Lucky-Enter/HPM5E31/hardware/HPM5E31.pdf

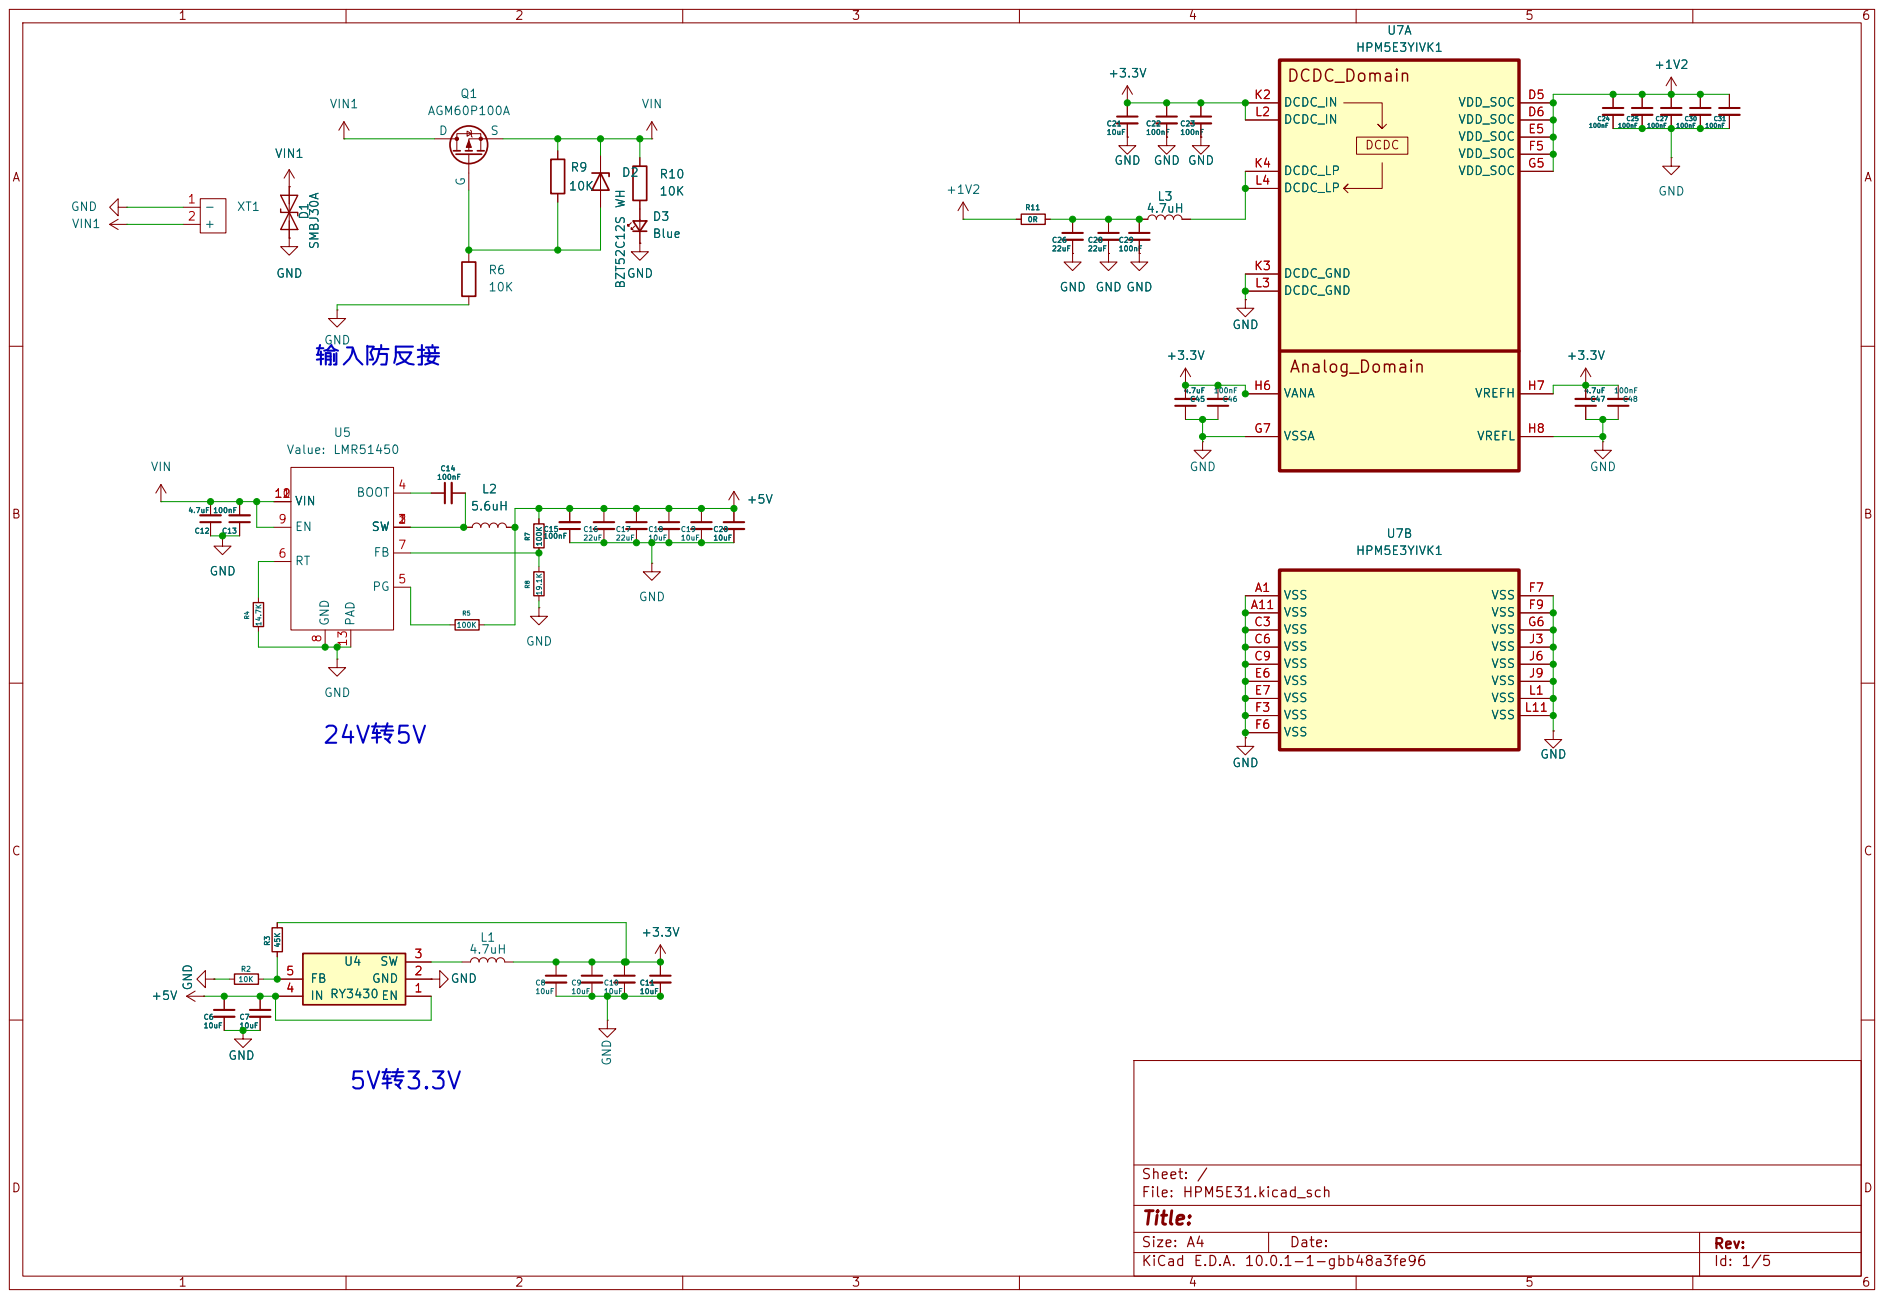
[picture p1: page 1]

Size: A4 | Rev:
KiCad E.D.A. 10.0.1-1-gbb48a3fe96 | Id: 1/5

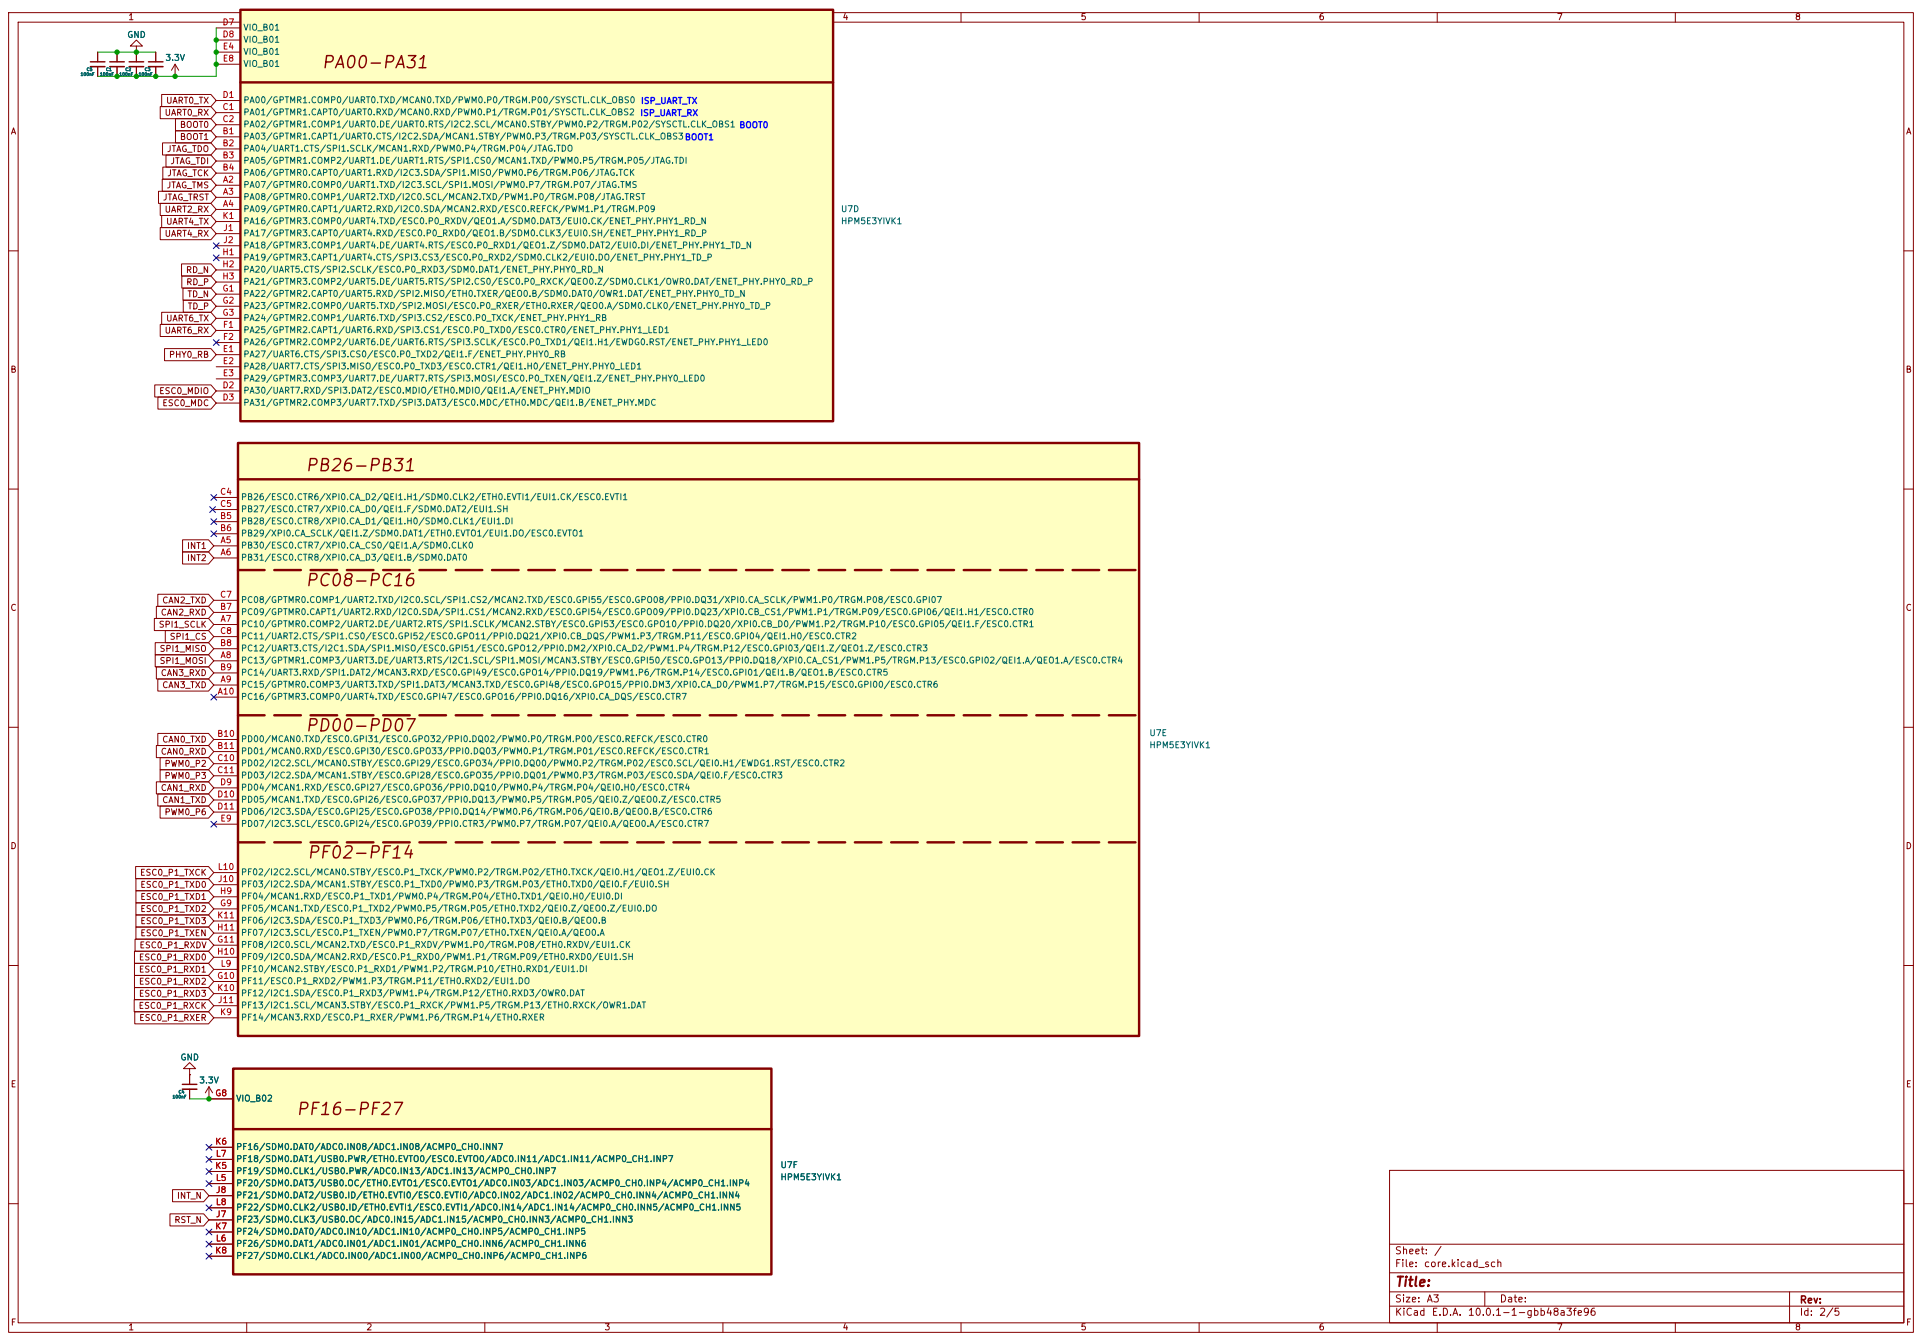
[picture p2: page 2]

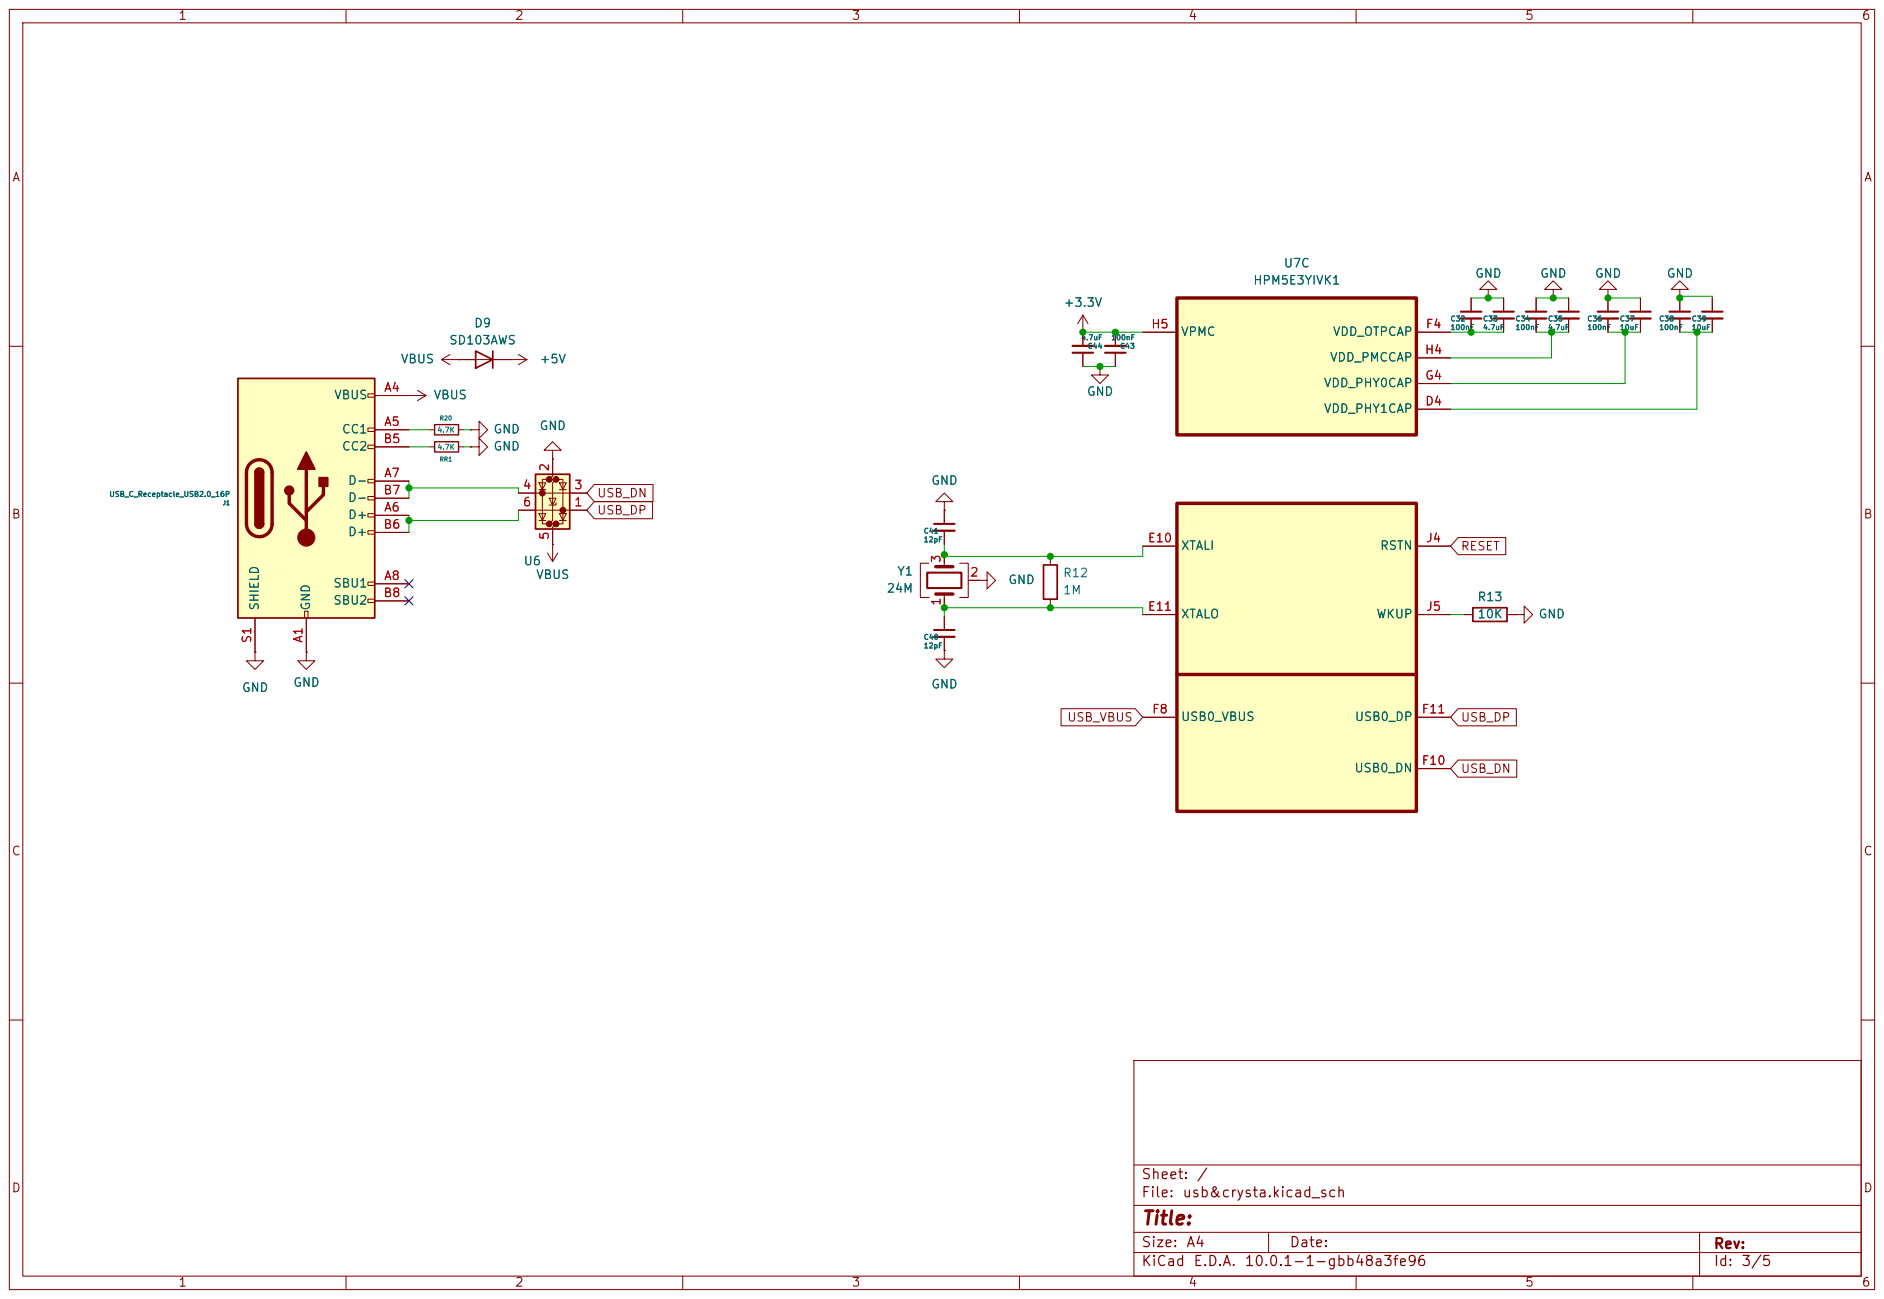
[picture p3: page 3]

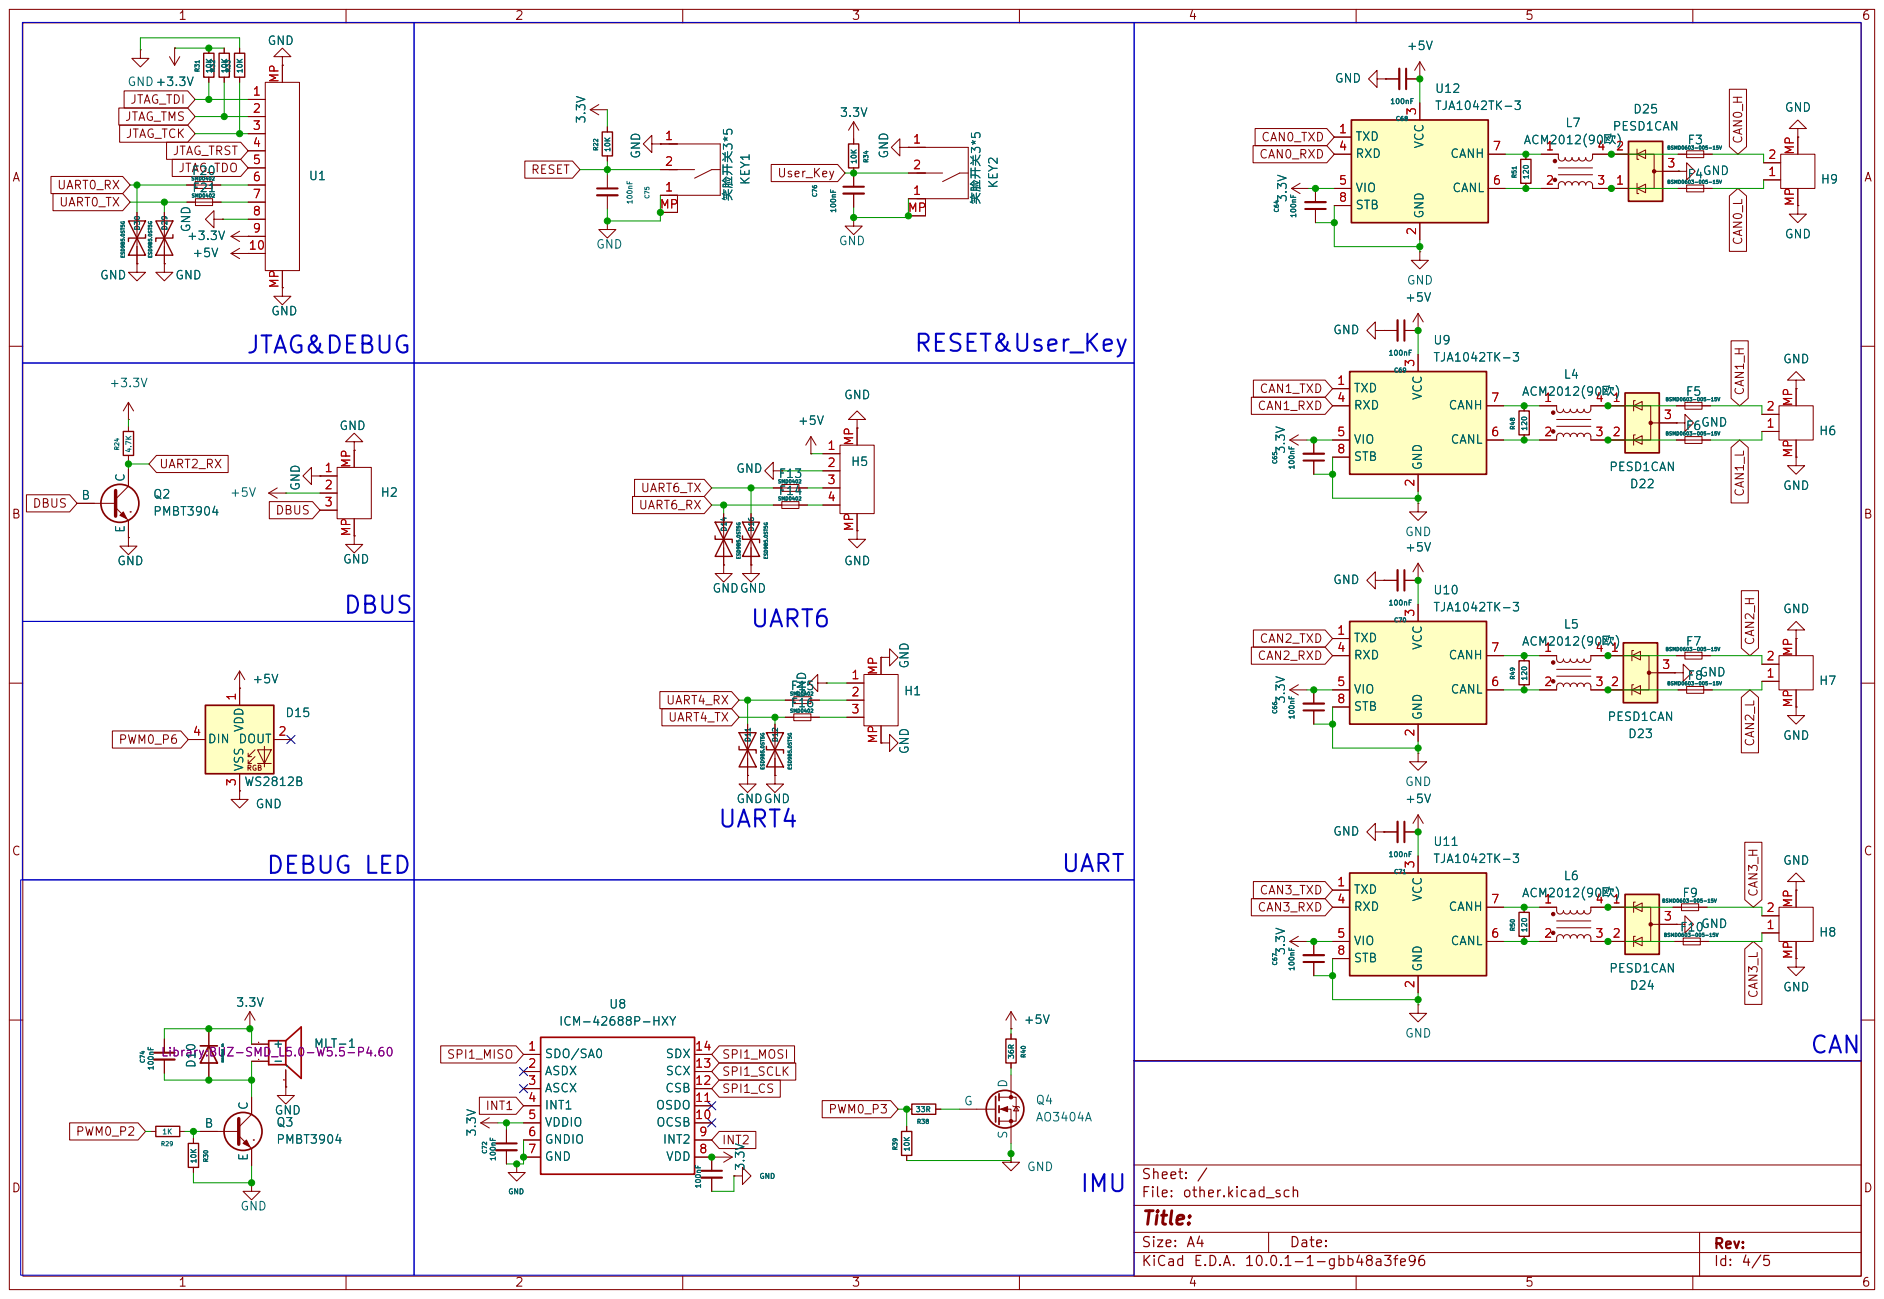
[picture p4: page 4]

JTAG&DEBUG | RESET&User_Key

GND

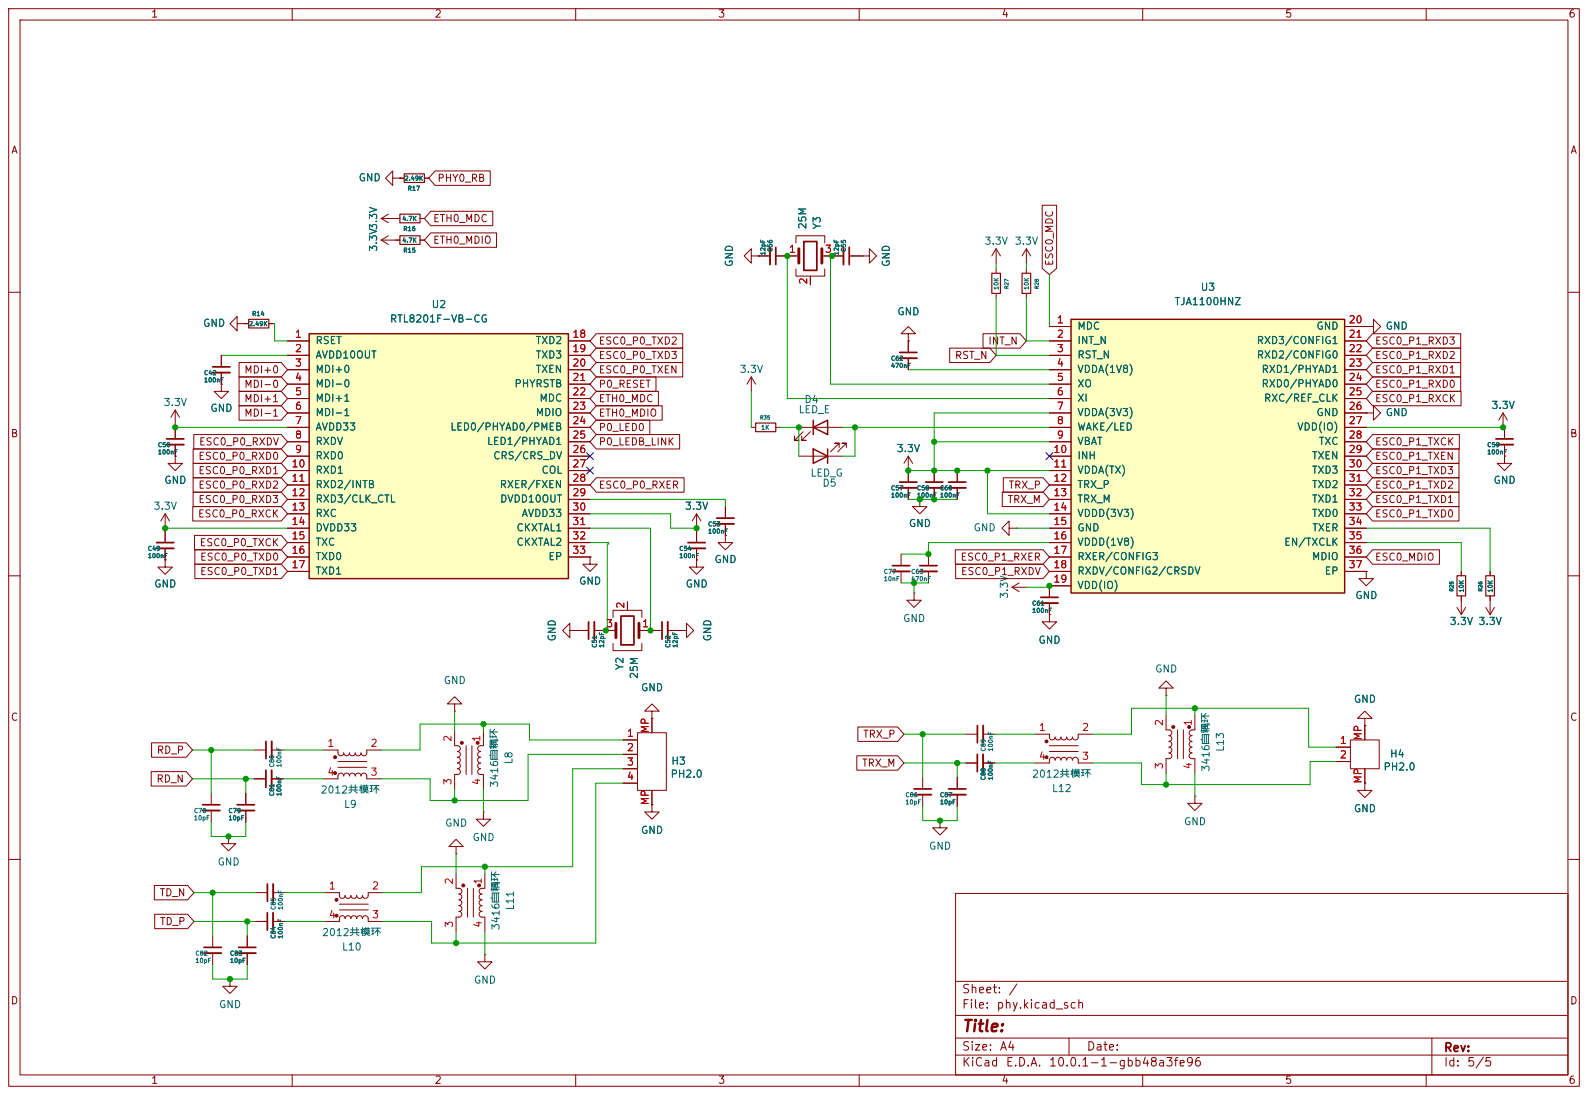
[picture p5: page 5]
