Lucky-Enter/HPM5E31/hardware/HPM5E31.kicad_pcb

## KiCad design hardware/HPM5E31.kicad_pcb (2026-10-18)

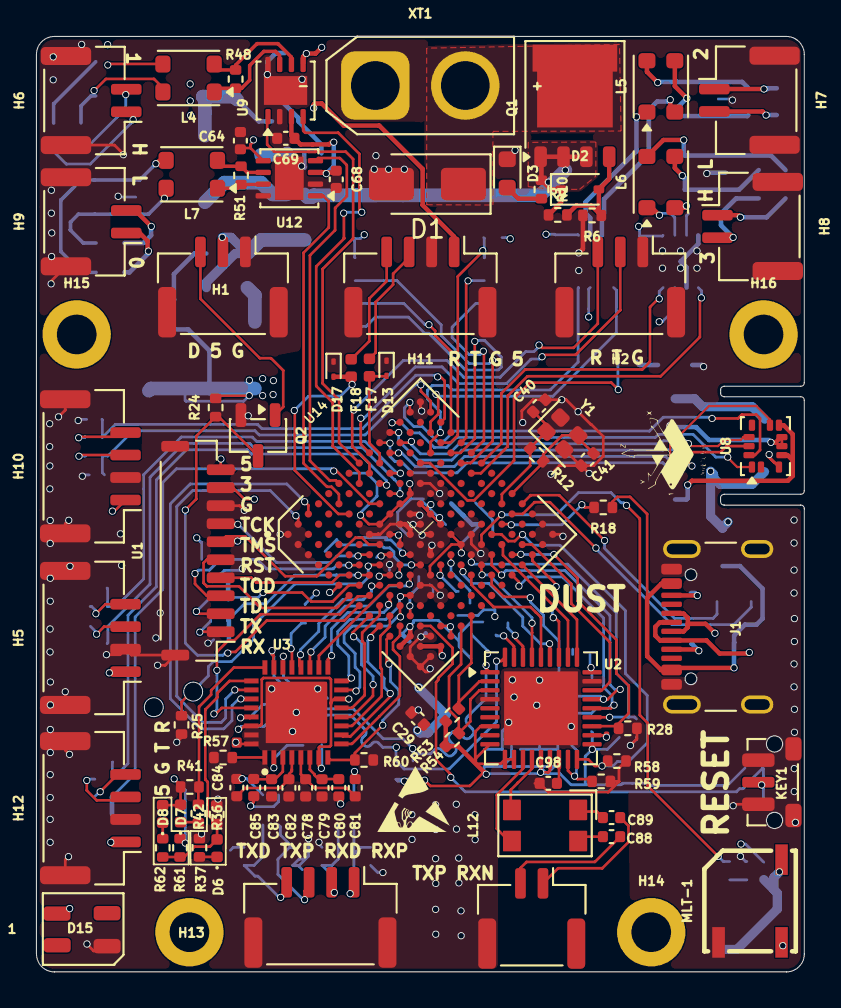
[picture p6: board HPM5E31.kicad_pcb from above]

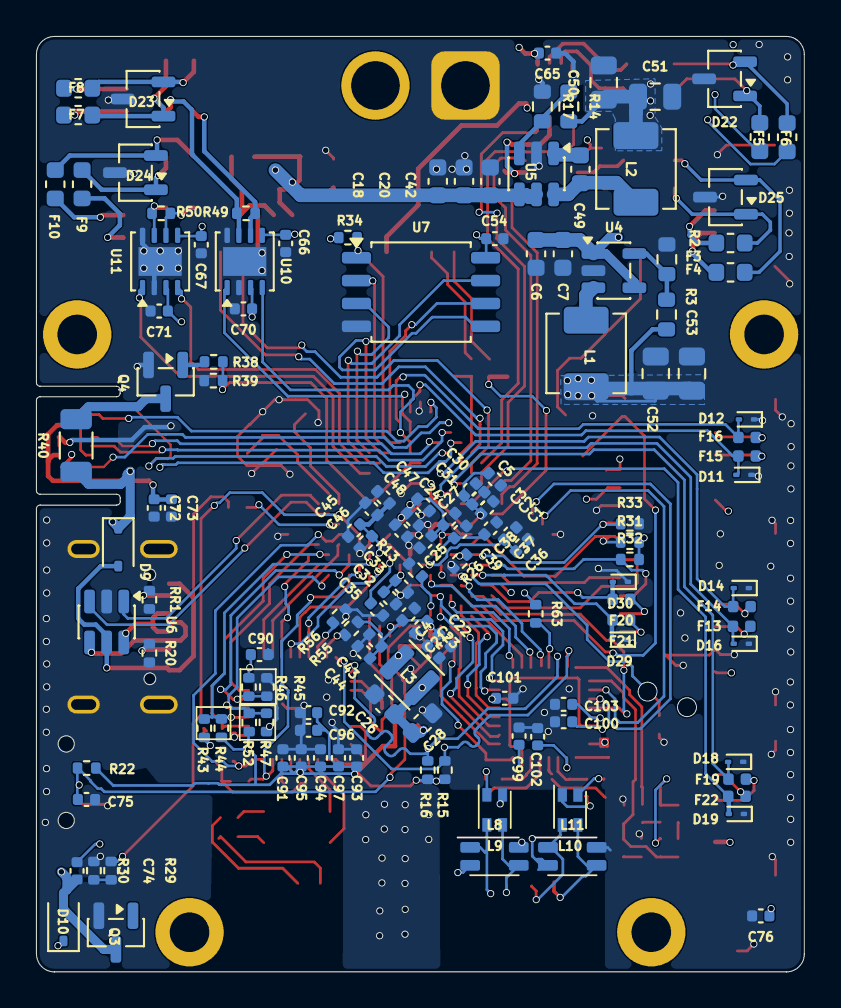
[picture p7: board HPM5E31.kicad_pcb from below]

Board: 4 copper layers, 42.7 x 52.0 mm, 223 parts (138 on the bottom side), 174 nets.

Parts:
C1, C2, C3, C4, C5, C22, C23, C24, C25, C27, C29, C30, C31, C32, C36, C38, C43, C46, C48, C54, C64, C65, C66, C67, C68, C69, C70, C71, C72, C73, C74, C75, C76, C80, C81, C84, C85, C88, C89, C90, C91, C92, C93, C94, C95, C96, C97, C99, C100, C101, C102, C103: 100nF; C_0402_1005Metric
C6, C7, C18, C20, C42: 10uF; C_0603_1608Metric
C21, C37, C39: 10uF; C_0402_1005Metric
C26, C28: 22uF; C_0603_1608Metric
C33, C35, C44, C45, C47: 4.7uF; C_0402_1005Metric
C40, C41: 12pF; C_0402_1005Metric
C49: 100nF; C_0603_1608Metric
C50, C51, C52, C53: 22uF 10V; C_0805_2012Metric
C78, C79, C82, C83: 10pF; C_0402_1005Metric
C98: 470nF; C_0402_1005Metric
D1: SMBJ30A; D_SMA
D2: BZT52C12S WH; D_SOD-323
D3: Blue; LED_0603_1608Metric
D6, D8: LED_G; LED_0402_1005Metric
D7: LED_E; LED_0402_1005Metric
D9: SD103AWS; D_SOD-323
D10: SD103AWS S4; D_SOD-323
D11, D12, D13, D14, D16, D17, D18, D19, D29, D30: ESD9B5.0ST5G; D_SOD-923
D15: WS2812B; LED_WS2812B-Mini_PLCC4_3.5x3.5mm
D22, D23, D24, D25: PESD1CAN; SOT-23-3
F3, F4, F5, F6, F7, F8, F9, F10: BSMD0603-005-15V; Fuse_0603_1608Metric
F13, F14, F15, F16, F17, F18, F19, F20, F21, F22: SMD0402; Fuse_0402_1005Metric
H1, H2: JST_GH_BM03B-GHS-TBT_1x03-1MP_P1.25mm_Vertical
H3: PH2.0; JST_GH_BM04B-GHS-TBT_1x04-1MP_P1.25mm_Vertical
H4: PH2.0; JST_GH_BM02B-GHS-TBT_1x02-1MP_P1.25mm_Vertical
H5, H10, H11, H12: JST_GH_BM04B-GHS-TBT_1x04-1MP_P1.25mm_Vertical
H6, H7, H8, H9: JST_GH_BM02B-GHS-TBT_1x02-1MP_P1.25mm_Vertical
H13, H14, H15, H16: MountingHole_Pad_MP; MountingHole_2.2mm_M2_DIN965_Pad
J1: USB_C_Receptacle_USB2.0_16P; USB_C_Receptacle_GCT_USB4105-xx-A_16P_TopMnt_Horizontal
KEY1: 笑脸开关3*5; SW_Push_1P1T-MP_NO_Horizontal_Alps_SKRTLAE010
L1, L2: 4.7uH; L_APV_APH0420
L3: 4.7uH; L_Wuerth_PMCI-252010
L4, L5, L6, L7: ACM2012(90欧); L_CommonModeChoke_Coilank_ACM3225
L8, L11: 3416自耦环; L_CommonMode_Wurth_WE-CNSW-1206
L9, L10: 2012共模环; L_CommonModeChoke_Coilcraft_0805USB
L12: 2012共模环; L_CommonModeChoke_Coilcraft_1812CAN
MLT-1: BUZ-SMD_L5.0-W5.5-P4.60
Q1: AGM60P100A; PQFN-8-EP_6x5mm_P1.27mm_Generic
Q2: PMBT3904; SOT-23-3
Q3: PMBT3904; SOT-23
Q4: AO3404A; SOT-23
R2: 10K; R_0603_1608Metric
R3: 45K; R_0603_1608Metric
R6, R9, R10, R13, R22, R25, R26, R28, R30, R31, R32, R33, R34, R39, R43, R44, R45, R46, R47, R52, R53, R54, R55, R56, R58, R59, R60, R63: 10K; R_0402_1005Metric
R12: 1M; R_0402_1005Metric
R14: 270K; R_0603_1608Metric
R15, R16, R20, R24, R36, R41, R61: 4.7K; R_0402_1005Metric
R17: 51K; R_0603_1608Metric
R18: 10R; R_0402_1005Metric
R29: 1K; R_0402_1005Metric
R37, R42, R62: 330R; R_0402_1005Metric
R38: 33R; R_0402_1005Metric
R40: 36R; R_1206_3216Metric
R48, R49, R50, R51: 120; R_0402_1005Metric
R57: 2.49K; R_0402_1005Metric
RR1: 4.7K; R_0402_1005Metric
U1: JST_SH_BM10B-SRSS-TB_1x10-1MP_P1.00mm_Vertical
U2: TJA1101B; QFN-36-1EP_6x6mm_P0.5mm_EP4.1x4.1mm
U3: RTL8201F-VB-CG
U4: RY3430; SOT-23-5
U5: RY8411; SOT-23-6
U6: USBLC6-2SC6; SOT-23-6
U7: W25Q128JVS; SOIC-8_5.3x5.3mm_P1.27mm
U8: ICM-42688P-HXY; LGA-14_3x2.5mm_P0.5mm_LayoutBorder3x4y
U9, U10, U11, U12: TJA1042TK-3; HVSON-8-1EP_3x3mm_P0.65mm_EP1.6x2.4mm
U14: HPM5E31IGN1; BGA-196_14x14_12.0x12.0mm_P0.8mm
XT1: AMASS_XT30U-M_1x02_P5.0mm_Vertical
Y1: 24M; Crystal_SMD_2016-4Pin_2.0x1.6mm

Connections:
3.3V: C1.2, C2.2, C3.2, C4.2, C5.2, C21.1, C22.1, C23.1, C43.2, C44.2, C45.2, C46.2, C47.2, C48.2, C52.1, C53.1, C54.1, C64.2, C65.2, C66.2, C67.2, C72.1, C73.1, C90.1, C91.1, C92.1, C93.2, C94.2, C95.2, C96.2, C97.2, C99.1, C100.1, C101.1, D7.2 (A), D8.2 (A), L1.2, R3.1, R15.2, R16.2, R22.2, R24.2, R31.2, R32.2, R34.2, R41.1, R44.1, R46.1, R52.1, R53.1, R54.1, R55.1, R61.1, R63.1, U1.9, U2.7 (VDDA(3V3)), U2.9 (V_BAT), U2.10 (INH), U2.11 (VDDA(TX)), U2.14 (VDDA(TX)), U2.15 (VDDD(3V3)), U2.19 (~VDD(IO)), U2.27 (~VDD(IO)), U3.7 (AVDD33), U3.14 (DVDD33), U3.30 (AVDD33), U7.8 (VCC), U8.5 (VDDIO), U8.8 (VDD), U9.5 (VIO), U10.5 (VIO), U11.5 (VIO), U12.5 (VIO), U14.E6 (VIO_B01), U14.E7 (VIO_B01), U14.E8 (VIO_B01), U14.E9 (VIO_B01), U14.J9 (VANA), U14.K6 (VIO_B01), U14.K9 (VREFH), U14.M1 (DCDC_IN), U14.M2 (DCDC_IN), U14.N4 (VPMC), U14.P4 (VPMC)
+1V2: C24.1, C25.1, C26.1, C27.1, C28.1, C29.1, C30.1, C31.1, L3.1, U14.F6 (VDD_SOC), U14.F9 (VDD_SOC), U14.G6 (VDD_SOC), U14.G9 (VDD_SOC), U14.H9 (VDD_SOC)
+5V: C6.1, C7.1, C50.1, C51.1, C68.1, C69.1, C70.1, C71.1, C74.1, C76.1, D9.1 (K), D10.1 (K), D15.1 (VDD), H1.2, H5.1, H10.1, H11.1, H12.1, L2.2, MLT-1.1 (+), R14.2, R40.1, U1.10, U4.1 (EN), U4.4 (IN), U9.3 (VCC), U10.3 (VCC), U11.3 (VCC), U12.3 (VCC)
BOOT0: R25.2, U14.G4 (PA02/GPTMR1.COMP1/UART0.DE/UART0.RTS/I2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)
BOOT1: R26.2, U14.G5 (PA03/GPTMR1.CAPT1/UART0.CTS/I2C2.SDA/MC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)
CAN0_H: F3.2, H9.2
CAN0_L: F4.2, H9.1
CAN0_RXD: U12.4 (RXD), U14.A6 (PC01/GPTMR1.CAPT0/UART0.RXD/MCAN0.RXD/E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)
CAN0_TXD: U12.1 (TXD), U14.B5 (PC00/GPTMR1.COMP0/UART0.TXD/MCAN0.TXD/E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)
CAN1_H: F5.2, H6.2
CAN1_L: F6.2, H6.1
CAN1_RXD: U9.4 (RXD), U14.B7 (PC04/UART1.CTS/SPI0.SCLK/MCAN1.RXD/ESC0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)
CAN1_TXD: U9.1 (TXD), U14.A8 (PC05/GPTMR1.COMP2/UART1.DE/UART1.RTS/SP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)
CAN2_H: F7.2, H7.2
CAN2_L: F8.2, H7.1
CAN2_RXD: U10.4 (RXD), U14.D12 (PD09/I2C0.SDA/MCAN2.RXD/ESC0.GPI22/ESC0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)
CAN2_TXD: U10.1 (TXD), U14.C13 (PD08/I2C0.SCL/MCAN2.TXD/ESC0.GPI23/ESC0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)
CAN3_H: F9.2, H8.2
CAN3_L: F10.2, H8.1
CAN3_RXD: U11.4 (RXD), U14.G14 (PD14/MCAN3.RXD/ESC0.GPI17/ESC0.GPO46/PP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)
CAN3_TXD: U11.1 (TXD), U14.G13 (PD15/MCAN3.TXD/ESC0.GPI16/ESC0.GPO47/PP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)
COL: U3.27 (COL), U14.A3 (PB26/ESC0.CTR6/XPI0.CA_D2/QEI1.H1/SDM0.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)
CRS: U3.26 (CRS/CRS_DV), U14.A2 (PB24/ESC0.CTR4/XPI0.CA_CS1/SDM0.CLK3/ET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)
DBUS: H1.3, Q2.1 (B)
ENET_PHY_LED0: R41.2, R42.2, U3.24 (LED0/PHYAD0/PMEB)
ENET_PHY_LED1: D6.2 (A), R36.1, R61.2, R62.2, U3.25 (LED1/PHYAD1)
ESC0_MDC: R16.1, U2.1 (MDC), U3.22 (MDC), U14.H5 (PA31/GPTMR2.COMP3/UART7.TXD/SPI3.DAT3/E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)
ESC0_MDIO: R15.1, U2.36 (MDIO), U3.23 (MDIO), U14.H4 (PA30/UART7.RXD/SPI3.DAT2/ESC0.MDIO/ETH0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)
ESC0_P0_RXCK: U3.13 (RXC), U14.J2 (PA21/GPTMR3.COMP2/UART5.DE/UART5.RTS/SP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)
ESC0_P0_RXD0: U3.9 (RXD0), U14.L2 (PA17/GPTMR3.CAPT0/UART4.RXD/ESC0.P0_RXD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)
ESC0_P0_RXD1: U3.10 (RXD1), U14.K1 (PA18/GPTMR3.COMP1/UART4.DE/UART4.RTS/ES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)
ESC0_P0_RXD2: U3.11 (RXD2/INTB), U14.K2 (PA19/GPTMR3.CAPT1/UART4.CTS/SPI3.CS3/ES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)
ESC0_P0_RXD3: U3.12 (RXD3/CLK_CTL), U14.J1 (PA20/UART5.CTS/SPI2.SCLK/ESC0.P0_RXD3/S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)
ESC0_P0_RXDV: R60.2, U3.8 (RXDV), U14.L1 (PA16/GPTMR3.COMP0/UART4.TXD/ESC0.P0_RXD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)
ESC0_P0_RXER: U3.28 (RXER/FXEN), U14.H2 (PA23/GPTMR2.COMP0/UART5.TXD/SPI2.MOSI/E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)
ESC0_P0_TXCK: U3.15 (TXC), U14.K3 (PA24/GPTMR2.COMP1/UART6.TXD/SPI3.CS2/ES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)
ESC0_P0_TXD0: U3.16 (TXD0), U14.K4 (PA25/GPTMR2.CAPT1/UART6.RXD/SPI3.CS1/ES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)
ESC0_P0_TXD1: U3.17 (TXD1), U14.J3 (PA26/GPTMR2.COMP2/UART6.DE/UART6.RTS/SP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)
ESC0_P0_TXD2: U3.18 (TXD2), U14.J4 (PA27/UART6.CTS/SPI3.CS0/ESC0.P0_TXD2/QE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)
ESC0_P0_TXD3: U3.19 (TXD3), U14.J5 (PA28/UART7.CTS/SPI3.MISO/ESC0.P0_TXD3/E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)
ESC0_P0_TXEN: U3.20 (TXEN), U14.H3 (PA29/GPTMR3.COMP3/UART7.DE/UART7.RTS/SP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)
ESC0_P1_RXCK: U2.25 (RXC/REF_CLK), U14.N12 (PF13/I2C1.SCL/MCAN3.STBY/ESC0.P1_RXCK/P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)
ESC0_P1_RXD0: R45.2, R46.2, U2.24 (RXD0/PHYAD1), U14.M10 (PF09/I2C0.SDA/MCAN2.RXD/ESC0.P1_RXD0/PW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)
ESC0_P1_RXD1: R47.2, R52.2, U2.23 (RXD1/PHYAD2), U14.P10 (PF10/MCAN2.STBY/ESC0.P1_RXD1/PWM1.P2/TR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)
ESC0_P1_RXD2: R43.2, R44.2, U2.22 (RXD2/CONFIG0), U14.L9 (PF11/ESC0.P1_RXD2/PWM1.P3/TRGM.P11/ETH0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)
ESC0_P1_RXD3: R28.1, U2.21 (RXD3/CONFIG1), U14.N11 (PF12/I2C1.SDA/ESC0.P1_RXD3/PWM1.P4/TRGM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)
ESC0_P1_RXDV: R58.2, U2.18 (RXDV/CONFIG2/CRSDV), U14.L11 (PF08/I2C0.SCL/MCAN2.TXD/ESC0.P1_RXDV/PW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)
ESC0_P1_RXER: R59.2, U2.17 (RXER/CONFIG3/TXCLK), U14.N9 (PF14/MCAN3.RXD/ESC0.P1_RXER/PWM1.P6/TRG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)
ESC0_P1_TXCK: U2.28 (TXC), U14.P11 (PF02/I2C2.SCL/MCAN0.STBY/ESC0.P1_TXCK/P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)
ESC0_P1_TXD0: U2.33 (TXD0), U14.M9 (PF03/I2C2.SDA/MCAN1.STBY/ESC0.P1_TXD0/P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)
ESC0_P1_TXD1: U2.32 (TXD1), U14.M8 (PF04/MCAN1.RXD/ESC0.P1_TXD1/PWM0.P4/TRG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)
ESC0_P1_TXD2: U2.31 (TXD2), U14.L8 (PF05/MCAN1.TXD/ESC0.P1_TXD2/PWM0.P5/TRG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)
ESC0_P1_TXD3: U2.30 (TXD3), U14.P12 (PF06/I2C3.SDA/ESC0.P1_TXD3/PWM0.P6/TRGM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)
ESC0_P1_TXEN: U2.29 (~TXEN), U14.M11 (PF07/I2C3.SCL/ESC0.P1_TXEN/PWM0.P7/TRGM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)
ESC0_REFCK: U2.20 (CLK_IN_OUT), U3.32 (CKXTAL2), U14.F1 (PA09/GPTMR0.CAPT1/UART2.RXD/I2C0.SDA/MC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)
ETH0_INT: R53.2, U2.2 (~INT_N), U14.P6 (PF26/SDM0.DAT1/ADC0.IN01/ADC1.IN01/ACMP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)
ETH0_RESET: R54.2, U2.3 (~RST_N), U14.P5 (PF28/SDM0.DAT3/ADC0.IN05/ADC1.IN05/ACMP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)
GND: C1.1, C2.1, C3.1, C4.1, C5.1, C6.2, C7.2, C18.2, C20.2, C21.2, C22.2, C23.2, C24.2, C25.2, C26.2, C27.2, C28.2, C29.2, C30.2, C31.2, C32.1, C33.1, C35.1, C36.1, C37.1, C38.1, C39.1, C40.2, C41.1, C42.2, C43.1, C44.1, C45.1, C46.1, C47.1, C48.1, C50.2, C51.2, C52.2, C53.2, C54.2, C64.1, C65.1, C66.1, C67.1, C68.2, C69.2, C70.2, C71.2, C72.2, C73.2, C75.2, C76.2, C78.2, C79.2, C82.2, C83.2, C90.2, C91.2, C92.2, C93.1, C94.1, C95.1, C96.1, C97.1, C98.1, C99.2, C100.2, C101.2, C102.2, C103.2, D1.2 (A2), D3.1 (K), D11.1 (A1), D12.1 (A1), D13.1 (A1), D14.1 (A1), D15.3 (VSS), D16.1 (A1), D17.1 (A1), D18.1 (A1), D19.1 (A1), D22.3 (A), D23.3 (A), D24.3 (A), D25.3 (A), D29.1 (A1), D30.1 (A1), H1.1, H1.MP, H2.1, H2.MP, H3.MP, H4.MP, H5.2, H5.MP, H6.MP, H7.MP, H8.MP, H9.MP, H10.2, H10.MP, H11.2, H11.MP, H12.2, H12.MP, J1.A1 (GND), J1.A12 (GND), J1.B1 (GND), J1.B12 (GND), J1.SH (SHIELD), KEY1.1, KEY1.MP, L8.2, L8.4, L11.2, L11.4, MLT-1.3 (NC), Q2.2 (E), Q3.2 (E), Q4.2 (S), R2.2, R6.2, R13.2, R17.1, R20.2, R25.1, R26.1, R28.2, R30.2, R33.2, R36.2, R37.2, R39.1, R43.1, R45.1, R47.1, R56.1, R57.1, R58.1, R59.1, R60.1, RR1.2, U1.8, U1.MP, U2.4 (SEL_1V8), U2.26 (GND), U2.37 (EP), U3.31 (CKXTAL1), U3.33 (EP), U4.2 (GND), U5.2 (GND), U6.2 (GND), U7.4 (GND), U8.6 (GNDIO), U8.7 (GND), U9.2 (GND), U9.8 (STB), U9.9 (GND), U10.2 (GND), U10.8 (STB), U10.9 (GND), U11.2 (GND), U11.8 (STB), U11.9 (GND), U12.2 (GND), U12.8 (STB), U12.9 (GND), U14.A1 (VSS), U14.A14 (VSS), U14.E5 (VSS), U14.E10 (VSS), U14.F7 (VSS), U14.F8 (VSS), U14.G7 (VSS), U14.G8 (VSS), U14.H7 (VSS), U14.H8 (VSSA), U14.J7 (VSS), U14.J8 (VREFL), U14.K5 (VSS), U14.K10 (VSS), U14.N1 (DCDC_GND), U14.N3 (VSS), U14.P1 (VSS), U14.P2 (DCDC_GND), U14.P14 (VSS), XT1.1 (-), Y1.2 (G), Y1.4 (G)
INT1: U8.4 (INT1), U14.A10 (PC18/GPTMR3.COMP1/UART4.DE/UART4.RTS/ES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)
INT2: U8.9 (INT2), U14.B10 (PC19/GPTMR3.CAPT1/UART4.CTS/SPI2.CS3/ES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)
JTAG_TCK: R33.1, U1.7, U14.F4 (PA06/GPTMR0.CAPT0/UART1.RXD/I2C3.SDA/SP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)
JTAG_TDI: R32.1, U1.3, U14.F3 (PA05/GPTMR1.COMP2/UART1.DE/UART1.RTS/SP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)
JTAG_TDO: U1.4, U14.F2 (PA04/UART1.CTS/SPI1.SCLK/MCAN1.RXD/PWM0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)
JTAG_TMS: R31.1, U1.6, U14.F5 (PA07/GPTMR0.COMP0/UART1.TXD/I2C3.SCL/SP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)
JTAG_TRST: U1.5, U14.G1 (PA08/GPTMR0.COMP1/UART2.TXD/I2C0.SCL/MC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)
MDI+0: C83.1, C85.1, U3.3 (MDI+0)
MDI+1: C78.1, C81.1, U3.5 (MDI+1)
MDI-0: C82.1, C84.1, U3.4 (MDI-0)
MDI-1: C79.1, C80.1, U3.6 (MDI-1)
unnamed: C80.2, L9.4
unnamed: C81.2, L9.1
unnamed: C84.2, L10.4
unnamed: C85.2, L10.1
unnamed: C88.1, L12.4
unnamed: C89.1, L12.3
unnamed: D2.2 (A), Q1.G, R6.1, R9.2
unnamed: D3.2 (A), R10.2
unnamed: D6.1 (K), R37.1
unnamed: D7.1 (K), R42.1
unnamed: D8.1 (K), R62.1
unnamed: C74.2, D10.2 (A), MLT-1.2 (-), Q3.3 (C)
unnamed: D22.1 (K), F5.1, L4.4
unnamed: D22.2 (K), F6.1, L4.3
unnamed: D23.1 (K), F7.1, L5.3
unnamed: D23.2 (K), F8.1, L5.4
unnamed: D24.1 (K), F9.1, L6.3
unnamed: D24.2 (K), F10.1, L6.4
unnamed: D25.1 (K), F3.1, L7.4
unnamed: D25.2 (K), F4.1, L7.3
unnamed: F13.2, H5.3
unnamed: F14.2, H5.4
unnamed: F15.2, H10.3
unnamed: F16.2, H10.4
unnamed: F17.2, H11.3
unnamed: F18.2, H11.4
unnamed: F19.2, H12.3
unnamed: F20.1, U1.2
unnamed: F21.1, U1.1
unnamed: F22.2, H12.4
unnamed: H3.1, L8.1, L9.2
unnamed: H3.2, L8.3, L9.3
unnamed: H3.3, L10.2, L11.1
unnamed: H3.4, L10.3, L11.3
unnamed: J1.A5 (CC1), R20.1
unnamed: J1.B5 (CC2), RR1.1
unnamed: J1.A6 (D+), J1.B6 (D+), U6.6 (I/O1)
unnamed: J1.A7 (D-), J1.B7 (D-), U6.4 (I/O2)
unnamed: L3.2, U14.N2 (DCDC_LP), U14.P3 (DCDC_LP)
unnamed: Q4.3 (D), R40.2
unnamed: Q4.1 (G), R38.1
unnamed: R29.1, R30.1
unnamed: R55.2, U2.35 (EN)
unnamed: R56.2, U2.34 (TXER)
unnamed: C98.2, U2.16 (VDDD(1V8))
unnamed: C102.1, U3.2 (AVDD10OUT)
unnamed: C103.1, U3.29 (DVDD10OUT)
unnamed: R57.2, U3.1 (RSET)
unnamed: R2.1, R3.2, U4.5 (FB)
unnamed: L1.1, U4.3 (SW)
unnamed: C49.2, U5.1 (BS)
unnamed: R14.1, R17.2, U5.3 (FB)
unnamed: C49.1, L2.1, U5.6 (LX)
unnamed: L4.1, R48.2, U9.7 (CANH)
unnamed: L4.2, R48.1, U9.6 (CANL)
unnamed: L5.2, R49.2, U10.7 (CANH)
unnamed: L5.1, R49.1, U10.6 (CANL)
unnamed: L6.2, R50.2, U11.7 (CANH)
unnamed: L6.1, R50.1, U11.6 (CANL)
unnamed: L7.1, R51.2, U12.7 (CANH)
unnamed: L7.2, R51.1, U12.6 (CANL)
unnamed: R18.2, U14.L12 (USB0_VBUS)
unnamed: R13.1, U14.L3 (WKUP)
unnamed: C41.2, R12.1, U14.K14 (XTALI), Y1.3
unnamed: C40.1, R12.2, U14.K13 (XTALO), Y1.1
unnamed: C35.2, U14.K8 (VDD_OTPCAP)
unnamed: C36.2, C37.2, U14.J6 (VDD_PHY0CAP)
unnamed: C38.2, C39.2, U14.H6 (VDD_PHY1CAP)
unnamed: C32.2, C33.2, U14.K7 (VDD_PMCCAP)
PHYRSTB: R63.2, U3.21 (PHYRSTB)
PWM0_P1: R29.2, U14.L10 (PF01/MCAN0.RXD/ESC0.MDIO/PWM0.P1/TRGM.P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)
PWM0_P4: R38.2, R39.2, U14.D11 (PD04/MCAN1.RXD/ESC0.GPI27/ESC0.GPO36/PP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)
RESET: C75.1, KEY1.2, R22.1, U14.M3 (RSTN)
RX_N: C89.2, H4.1
SPI2_CS: R34.1, U7.1 (~CS), U14.D13 (PC27/UART6.CTS/SPI2.CS0/ESC0.GPI36/ESC0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)
SPI2_D2: U7.3 (~WP/IO_{2}), U14.F14 (PC30/UART7.RXD/SPI2.DAT2/ESC0.GPI33/ESC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)
SPI2_D3: U7.7 (~HOLD/~RESET/IO_{3}), U14.F13 (PC31/GPTMR2.COMP3/UART7.TXD/SPI2.DAT3/E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)
SPI2_MISO: U7.2 (DO/IO_{1}), U14.E14 (PC28/UART7.CTS/SPI2.MISO/ESC0.GPI35/ESC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)
SPI2_MOSI: U7.5 (DI/IO_{0}), U14.E13 (PC29/GPTMR3.COMP3/UART7.DE/UART7.RTS/SP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)
SPI2_SCLK: U7.6 (CLK), U14.D14 (PC26/GPTMR2.COMP2/UART6.DE/UART6.RTS/SP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)
SPI3_CS: U8.12 (CSB), U14.B11 (PC21/GPTMR3.COMP2/UART5.DE/UART5.RTS/SP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)
SPI3_MISO: U8.1 (SDO/SA0), U14.A12 (PC22/GPTMR2.CAPT0/UART5.RXD/SPI3.MISO/E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)
SPI3_MOSI: U8.14 (SDX), U14.A13 (PC23/GPTMR2.COMP0/UART5.TXD/SPI3.MOSI/E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)
SPI3_SCLK: U8.13 (SCX), U14.A11 (PC20/UART5.CTS/SPI3.SCLK/ESC0.GPI43/ESC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)
TRX_N: L12.2, U2.13 (TRX_M)
TRX_P: L12.1, U2.12 (TRX_P)
TX_P: C88.2, H4.2
UART0_RX: D29.2 (A2), F21.2, U14.G3 (PA01/GPTMR1.CAPT0/UART0.RXD/MCAN0.RXD/P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)
UART0_TX: D30.2 (A2), F20.2, U14.G2 (PA00/GPTMR1.COMP0/UART0.TXD/MCAN0.TXD/P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)
UART1_RX: H2.3, U14.B8 (PC06/GPTMR0.CAPT0/UART1.RXD/I2C3.SDA/SP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)
UART1_TX: H2.2, U14.A9 (PC07/GPTMR0.COMP0/UART1.TXD/I2C3.SCL/SP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)
UART2_RX: D17.2 (A2), F18.1, U14.C5 (PC09/GPTMR0.CAPT1/UART2.RXD/I2C0.SDA/SP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)
UART2_TX: D13.2 (A2), F17.1, U14.B9 (PC08/GPTMR0.COMP1/UART2.TXD/I2C0.SCL/SP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)
UART3_RX: D19.2 (A2), F22.1, U14.D7 (PC14/UART3.RXD/SPI1.DAT2/MCAN3.RXD/ESC0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)
UART3_TX: D18.2 (A2), F19.1, U14.C8 (PC15/GPTMR0.COMP3/UART3.TXD/SPI1.DAT3/M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)
UART4_RX: D14.2 (A2), F14.1, U14.C9 (PC17/GPTMR3.CAPT0/UART4.RXD/ESC0.GPI46/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)
UART4_TX: D16.2 (A2), F13.1, U14.D8 (PC16/GPTMR3.COMP0/UART4.TXD/ESC0.GPI47/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)
UART5_RX: Q2.3 (C), R24.1, U14.H1 (PA22/GPTMR2.CAPT0/UART5.RXD/SPI2.MISO/E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)
UART6_RX: D12.2 (A2), F16.1, U14.C14 (PC25/GPTMR2.CAPT1/UART6.RXD/SPI2.CS1/ES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)
UART6_TX: D11.2 (A2), F15.1, U14.B14 (PC24/GPTMR2.COMP1/UART6.TXD/SPI2.CS2/ES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)
USB_DN: U6.3 (I/O2), U14.L13 (USB0_DN)
USB_DP: U6.1 (I/O1), U14.L14 (USB0_DP)
VBUS: D9.2 (A), J1.A4 (VBUS), J1.A9 (VBUS), J1.B4 (VBUS), J1.B9 (VBUS), R18.1, U6.5 (VBUS)
VIN: C18.1, C20.1, C42.1, D2.1 (K), Q1.S, R9.1, R10.1, U5.4 (EN), U5.5 (IN)
VIN1: D1.1 (A1), Q1.D, XT1.2 (+)
